mossmann/luna/hardware/rev0/luna_rev0.kicad_pcb

## KiCad design hardware/rev0/luna_rev0.kicad_pcb (2023-04-16)

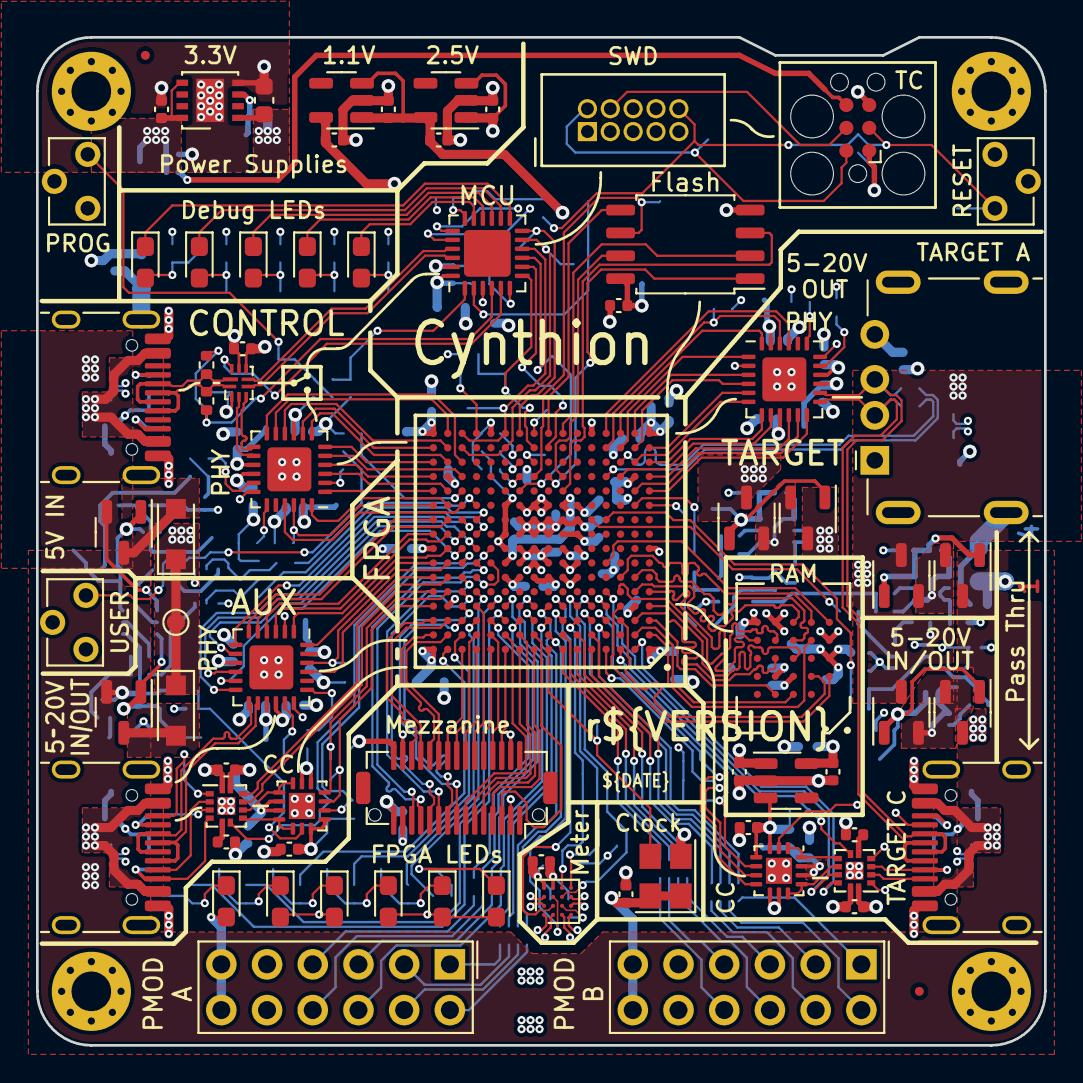
[picture p1: board luna_rev0.kicad_pcb from above]

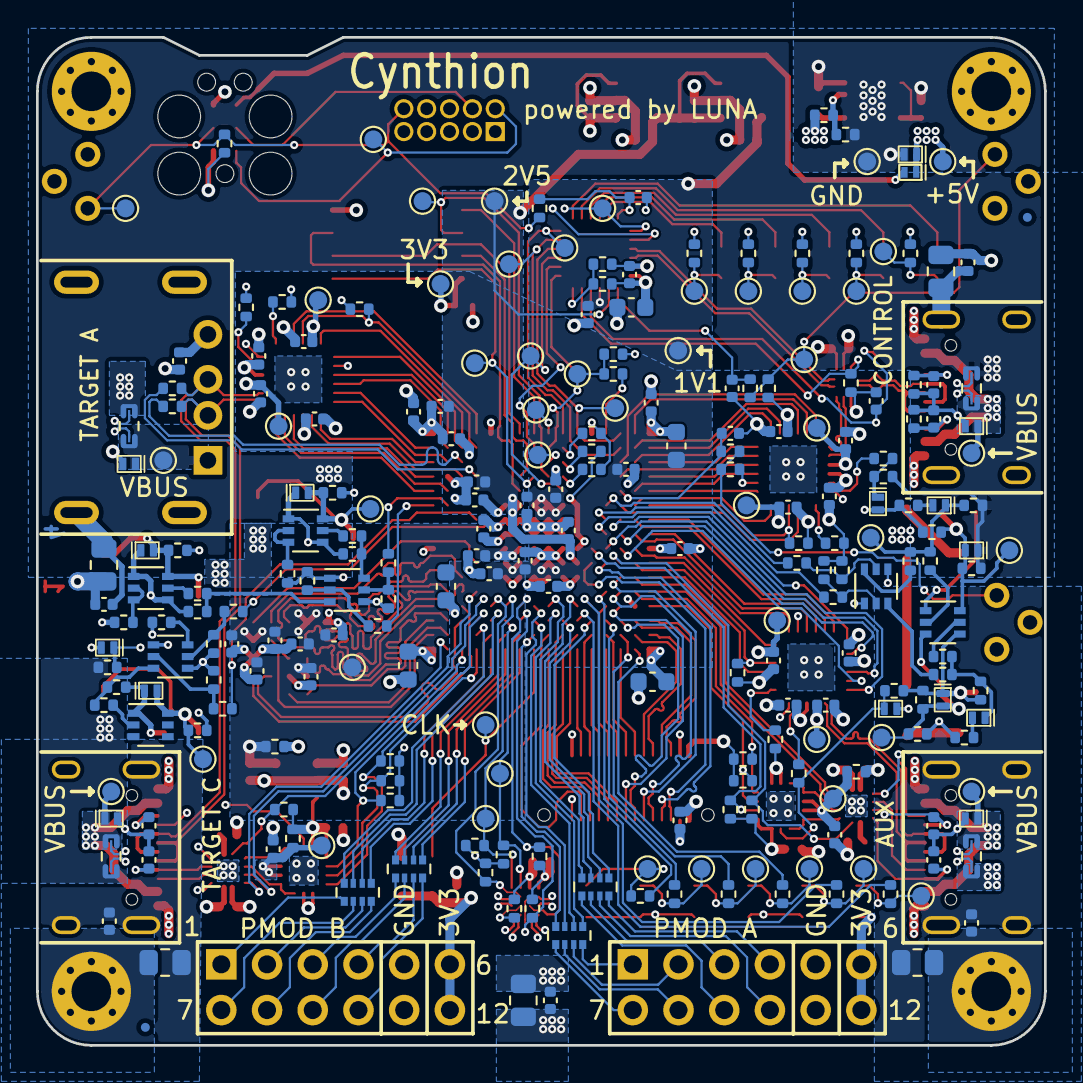
[picture p2: board luna_rev0.kicad_pcb from below]

Board: 4 copper layers, 56.0 x 56.0 mm, 322 parts (244 on the bottom side), 289 nets.

Parts:
C1, C2, C3, C4, C20, C73: 2.2uF; C_0603_1608Metric
C5, C6, C8, C13, C16, C17, C18, C19, C21, C22, C28, C29, C30, C34, C36, C37, C41, C42, C43, C48, C49, C50, C56, C58, C59, C60, C72, C74, C76, C77, C78: 1uF; C_0402_1005Metric
C7, C9, C10, C11, C12, C14, C15, C23, C24, C26, C27, C31, C32, C33, C35, C38, C39, C40, C44, C45, C46, C51, C57, C61, C63, C64, C65, C66, C67, C68, C69, C70, C71, C75: 0.1uF; C_0402_1005Metric
C25, C47, C52, C53, C54, C55: 330pF; C_0402_1005Metric
C62: 1nF; C_0402_1005Metric
D1, D8: SCHOTTKY; D_SOD-123F
D2: RED; LED_0603_1608Metric_Pad1.05x0.95mm_HandSolder
D3: ORANGE; LED_0603_1608Metric_Pad1.05x0.95mm_HandSolder
D4: YELLOW; LED_0603_1608Metric_Pad1.05x0.95mm_HandSolder
D5: GREEN; LED_0603_1608Metric_Pad1.05x0.95mm_HandSolder
D6: BLUE; LED_0603_1608Metric_Pad1.05x0.95mm_HandSolder
D7: PURPLE; LED_0603_1608Metric_Pad1.05x0.95mm_HandSolder
D9: SCHOTTKY; DSN1006-2
D10, D14: ICE BLUE; LED_0603_1608Metric_Pad1.05x0.95mm_HandSolder
D11, D13: PINK; LED_0603_1608Metric_Pad1.05x0.95mm_HandSolder
D12: WHITE; LED_0603_1608Metric_Pad1.05x0.95mm_HandSolder
D15, D18, D22: 24±2%; DFN1006-2
D16, D19, D20, D27, D28, D29: 6.2±2%; DFN1006-2
D17, D21: 5.6±2%; DFN1006-2
D23, D24, D25, D26: TVS; DFN1006-2
FID1, FID2, FID3, FID4: Fiducial; Fiducial_0.5mm_Mask1mm
H1, H2, H3, H4: MountingHole; MountingHole_2.2mm_M2_Pad_Via
IC1: ECP5-BGA256; lattice_cabga256
J1, J2, J4: USB_C; USB_C_Receptacle_HRO_TYPE-C-31-M-12
J3: USB_A; USB_A_Kycon_KUSBXHT-SB-AS1N-B30-NF_Horizontal
J5: MEZZANINE; Amphenol_10132798-03
J6: MCU_SWD; SWD_CONNECTOR_LARGE_BOX
J7: PMOD_A; PinSocket_2x06_P2.54mm_PMOD
J8: PMOD_B; PinSocket_2x06_P2.54mm_PMOD
J10: TC_SWD; Tag-Connect_TC2030-IDC-FP_2x03_P1.27mm_Vertical
Q1, Q2, Q4, Q5, Q6, Q7, Q9, Q12: PMOS; SOT-23-3
Q3, Q8, Q11: 2NPN; SOT-363_SC-70-6
Q10, Q13, Q14, Q15: 2PNP; SOT-363_SC-70-6
R1, R2, R42, R59: 0.02±1%; R_0603_1608Metric_Current_Sense
R3, R47, R48, R49, R60, R61, R69, R70, R76, R77, R104, R105, R107: 33k; R_0402_1005Metric
R4, R43, R50, R51, R103: 0; R_0805_2012Metric
R5, R8, R9, R10, R30, R31, R33, R38, R40, R63, R65, R71, R78, R83, R84, R88, R97, R98: 2.2k; R_0402_1005Metric
R6, R12, R13, R14, R15, R22, R23, R24, R25, R29, R37, R39, R41, R52, R53, R64, R66, R72, R79, R85, R86, R87, R89, R99, R100, R101, R106: 10k; R_0402_1005Metric
R7, R11, R34, R35, R44, R45, R46: 5.1k; R_0402_1005Metric
R16, R18, R20: 8.06k±1%; R_0402_1005Metric
R17, R19, R21: 20k; R_0402_1005Metric
R26, R27, R28, R57, R58: 1k; R_0402_1005Metric
R32, R36, R54, R102: 0; R_0402_1005Metric
R55, R56, R68, R75: 820k; R_0402_1005Metric
R62, R90, R91, R92, R93, R94, R95, R96: 100k; R_0402_1005Metric
R67, R73, R74, R80, R82: 18.7k±1%; R_0402_1005Metric
R81: 57.6k±1%; R_0402_1005Metric
RN1, RN2, RN3, RN4: 33; R_Array_Convex_4x0402
SW1: BTN_PROGRAM; SW_Tactile_SPST_Angled_TC-1109DE-B-F
SW2: BTN_RESET; SW_Tactile_SPST_Angled_TC-1109DE-B-F
SW3: BTN_USER; SW_Tactile_SPST_Angled_TC-1109DE-B-F
TP1, TP2, TP3, TP4, TP5, TP6, TP7, TP8, TP9, TP10, TP11, TP12, TP13, TP14, TP15, TP16, TP17, TP18, TP19, TP20, TP21, TP22, TP23, TP24, TP26, TP27, TP28, TP29, TP30, TP31, TP32, TP34, TP35, TP36, TP37, TP38, TP39, TP40, TP41, TP42, TP43, TP44, TP46, TP47, TP49, TP50, TP51, TP52, TP53, TP54, TP55: TestPoint; TestPoint_Pad_D1.0mm
U1: PAC1954; WLCSP-16_2.225x2.170mm_Layout4x4_P0.5mm
U2, U12: FUSB302B; WQFN-14-1EP_2.5x2.5mm_P0.5mm_EP1.45x1.45mm
U3: 3V3REG; DFN-8-1EP_3x3mm_P0.65mm_EP1.55x2.4mm
U4: 1V15REG; SOT-23-5
U5: 2V5REG; SOT-23-5
U6: ATSAMD11; QFN-24-1EP_4x4mm_P0.5mm_EP2.6x2.6mm
U7: W25Q32JVSS; SOIC-8_5.23x5.23mm_P1.27mm
U8, U9, U11: USB3343-CP; VQFN-24-1EP_4x4mm_P0.5mm_EP2.45x2.45mm
U10: HyperRAM; BGA-24_5x5_6.0x8.0mm
U13, U14: DPO2036; Diodes_UQFN2020-12_Type-B
U15: 1V8REG; SOT-23-5
U16: PI3USB102G; Diodes_10-TQFN_ZL
Y1: Osc60MHz; Crystal_SMD_3225-4Pin_3.2x2.5mm

Connections:
+1V1: C1.1, C3.1, C7.1, C9.1, C11.1, C13.1, C15.1, C17.1, C29.1, IC1.G6 (VCC_1), IC1.G7 (VCC_2), IC1.G9 (VCC_3), IC1.L8 (VCC_4), IC1.L9 (VCC_5), IC1.L10 (VCC_6), TP4.1, U4.5 (VOUT), U6.3 (PA04)
+2V5: C22.1, C24.1, C26.1, C27.1, C30.1, IC1.G11 (VCCAUX_1), IC1.L7 (VCCAUX_2), TP5.1, U4.1 (VIN), U4.3 (EN), U5.5 (VOUT), U6.2 (PA03)
+3V3: C2.1, C4.1, C8.1, C10.1, C12.1, C14.1, C16.1, C18.1, C20.1, C23.1, C28.1, C33.1, C34.1, C35.1, C38.1, C39.1, C40.1, C41.1, C44.1, C46.1, C49.1, C56.1, C58.1, C59.1, C61.1, C66.1, C67.1, C72.1, C73.1, C74.1, D2.2 (A), D3.2 (A), D4.2 (A), D5.2 (A), D6.2 (A), D7.2 (A), IC1.F6 (VCCIO0_1), IC1.F7 (VCCIO0_2), IC1.F10 (VCCIO1_1), IC1.F11 (VCCIO1_2), IC1.H11 (VCCIO2_1), IC1.J6 (VCCIO6_1), IC1.J7 (VCCIO6_2), IC1.J11 (VCCIO2_2), IC1.K11 (VCCIO3_1), IC1.L6 (VCCIO8), IC1.L11 (VCCIO3_2), J5.15, J5.16, J6.1 (VTref), J7.6, J7.12, J8.6, J8.12, J10.1, R6.1, R7.1, R8.1, R9.1, R10.1, R11.1, R13.2, R25.1, R32.2, R33.1, R36.2, R37.1, R38.1, R39.1, R52.1, R54.1, R81.1, R83.1, R84.1, R85.1, R86.1, R87.1, R97.1, R98.1, R99.1, R100.1, R101.1, R106.1, TP3.1, U1.A4 (VDD), U2.3 (VDD), U2.4 (VDD), U3.1 (OUT), U5.1 (VIN), U5.3 (EN), U6.24 (VDD), U7.8 (VCC), U8.2 (CLKOUT), U8.9 (VDDIO), U8.16 (VBAT), U8.18 (ID), U9.2 (CLKOUT), U9.9 (VDDIO), U9.16 (VBAT), U9.18 (ID), U11.2 (CLKOUT), U11.9 (VDDIO), U11.16 (VBAT), U11.18 (ID), U12.3 (VDD), U12.4 (VDD), U13.12 (VSYS), U14.12 (VSYS), U15.1 (VIN), U15.3 (EN), U16.9 (VCC), Y1.1 (EN), Y1.4 (VDD)
+5V: C6.1, D1.1 (K), D8.1 (K), D9.1 (K), D19.1 (K), TP30.1, TP49.1, U3.5 (EN), U3.8 (IN)
/AUX Port/AUX.CLK: IC1.F16 (PR14A), U11.21 (REFCLK/XI)
/AUX Port/AUX.DATA0: IC1.J16 (PR23A), U11.4 (DATA0)
/AUX Port/AUX.DATA1: IC1.K15 (PR23D), U11.5 (DATA1)
/AUX Port/AUX.DATA2: IC1.K16 (PR23C), U11.6 (DATA2)
/AUX Port/AUX.DATA3: IC1.J13 (PR17C), U11.7 (DATA3)
/AUX Port/AUX.DATA4: IC1.J14 (PR20C), U11.8 (DATA4)
/AUX Port/AUX.DATA5: IC1.H13 (PR17B), U11.10 (DATA5)
/AUX Port/AUX.DATA6: IC1.H14 (PR14D), U11.11 (DATA6)
/AUX Port/AUX.DATA7: IC1.K14 (PR20D), U11.12 (DATA7)
/AUX Port/AUX.DIR: IC1.H15 (PR20B), U11.1 (DIR)
/AUX Port/AUX.NXT: IC1.J15 (PR23B), U11.3 (NXT)
/AUX Port/AUX.STP: IC1.G16 (PR20A), U11.24 (STP)
/AUX Port/AUX.~RESET: IC1.G15 (PR14B), R24.1, U11.22 (RESET)
/AUX Port/AUX_CC1: C52.1, J1.A5 (CC1), U14.3 (CC1C)
/AUX Port/AUX_CC1S: U12.10 (CC1), U12.11 (CC1), U14.8 (CC1S)
/AUX Port/AUX_CC2: C53.1, J1.B5 (CC2), U14.4 (CC2C)
/AUX Port/AUX_CC2S: U12.1 (CC2), U12.14 (CC2), U14.7 (CC2S)
/AUX Port/AUX_D+: J1.A6 (D+), J1.B6 (D+), U11.14 (D+)
/AUX Port/AUX_D-: J1.A7 (D-), J1.B7 (D-), U11.13 (D-)
/AUX Port/AUX_PHY_1V8: C50.1, TP35.1, U11.23 (VDD18)
/AUX Port/AUX_SBU1: J1.A8 (SBU1), U14.2 (SBU2C)
/AUX Port/AUX_SBU1S: IC1.E16 (PR11D), U14.9 (SBU2S)
/AUX Port/AUX_SBU2: J1.B8 (SBU2), U14.1 (SBU1C)
/AUX Port/AUX_SBU2S: IC1.F15 (PR11C), U14.10 (SBU1S)
/AUX Port/AUX_SCL: IC1.D16 (PR8A), R38.2, U12.6 (SCL)
/AUX Port/AUX_SDA: IC1.E15 (PR8B), R33.2, U12.7 (SDA)
/AUX Port/AUX_VCONN: C51.1, R32.1, TP37.1, U12.12 (VCONN), U12.13 (VCONN)
/AUX Port/~AUX_FAULT: IC1.G14 (PR14C), R99.2, U14.6 (FAULTB)
/AUX Port/~AUX_INT: IC1.H12 (PR17A), R39.2, U12.5 (INT_N)
/CONTROL Port/CONTROL.CLK: IC1.L14 (PR32C), U8.21 (REFCLK/XI)
/CONTROL Port/CONTROL.DATA0: IC1.N16 (PR32A), U8.4 (DATA0)
/CONTROL Port/CONTROL.DATA1: IC1.N14 (PR35D), U8.5 (DATA1)
/CONTROL Port/CONTROL.DATA2: IC1.P16 (PR35A), U8.6 (DATA2)
/CONTROL Port/CONTROL.DATA3: IC1.P15 (PR32B), U8.7 (DATA3)
/CONTROL Port/CONTROL.DATA4: IC1.R16 (PR35B), U8.8 (DATA4)
/CONTROL Port/CONTROL.DATA5: IC1.R15 (PR38C), U8.10 (DATA5)
/CONTROL Port/CONTROL.DATA6: IC1.T15 (PR38D), U8.11 (DATA6)
/CONTROL Port/CONTROL.DATA7: IC1.P14 (PR38B), U8.12 (DATA7)
/CONTROL Port/CONTROL.DIR: IC1.M16 (PR26C), U8.1 (DIR)
/CONTROL Port/CONTROL.NXT: IC1.M15 (PR26D), U8.3 (NXT)
/CONTROL Port/CONTROL.STP: IC1.L15 (PR26B), U8.24 (STP)
/CONTROL Port/CONTROL.~RESET: IC1.L16 (PR26A), R22.1, U8.22 (RESET)
/CONTROL Port/CONTROL_CC1: C25.1, J2.A5 (CC1), R34.2
/CONTROL Port/CONTROL_CC2: C47.1, J2.B5 (CC2), R35.2
/CONTROL Port/CONTROL_D+: J2.A6 (D+), J2.B6 (D+), R56.2, U16.2 (D-)
/CONTROL Port/CONTROL_D-: J2.A7 (D-), J2.B7 (D-), R55.1, U16.1 (D+)
/CONTROL Port/CONTROL_FPGA_D+: U8.14 (D+), U16.4 (1D-)
/CONTROL Port/CONTROL_FPGA_D-: U8.13 (D-), U16.5 (1D+)
/CONTROL Port/CONTROL_MCU_D+: U6.22 (PA25), U16.6 (2D-)
/CONTROL Port/CONTROL_MCU_D-: U6.21 (PA24), U16.7 (2D+)
/CONTROL Port/CONTROL_PHY_1V8: C37.1, TP17.1, U8.23 (VDD18)
/CONTROL Port/CONTROL_RESET_DETECT: C62.1, R55.2, R56.1, U6.4 (PA05)
/CONTROL Port/CONTROL_SWITCH: R15.1, U6.5 (PA06), U16.10 (S)
/CONTROL Port/CONTROL_VBUS_CLAMPED: D22.1 (K), R17.1, R46.1
/CONTROL Port/~AUX_VBUS_IN_EN: IC1.L13 (PR29C), R78.2
/CONTROL Port/~BTN_USER: R106.2, R107.2, SW3.1
/CONTROL Port/~CONTROL_VBUS_IN_EN: IC1.K13 (PR29A), R71.2
/CONTROL Port/~FPGA_SELF_PROGRAM: IC1.T13 (PR44B), R5.2
/Clock and Pmod/CLKIN_60MHZ: IC1.A8 (PT29B), TP1.1, Y1.3 (OUT)
/Clock and Pmod/TARGET_C.SBU1S: IC1.A2 (PT4A), U13.10 (SBU1S)
/Clock and Pmod/TARGET_C.SBU2S: IC1.E4 (PT9A), U13.9 (SBU2S)
/Clock and Pmod/TARGET_C.SCL: IC1.A4 (PT6B), R98.2, U2.6 (SCL)
/Clock and Pmod/TARGET_C.SDA: IC1.C4 (PT11A), R97.2, U2.7 (SDA)
/Clock and Pmod/TARGET_C.~FAULT: IC1.D4 (PT9B), R100.2, U13.6 (FAULTB)
/Clock and Pmod/TARGET_C.~INT: IC1.A3 (PT6A), R37.2, U2.5 (INT_N)
/Debugger and FPGA Configuration/D0: IC1.T8 (D0/PICO/PB11B), U7.5 (DI(IO0))
/Debugger and FPGA Configuration/D1: IC1.T7 (D1/POCI/PB11A), U7.2 (DO(IO1))
/Debugger and FPGA Configuration/D2: IC1.M7 (D2/PB9B), U7.3 (IO2)
/Debugger and FPGA Configuration/D3: IC1.N7 (D3/PB9A), U7.7 (IO3)
/Debugger and FPGA Configuration/FPGA_CFG0: IC1.N10 (CFG_0), R12.1
/Debugger and FPGA Configuration/FPGA_CFG1: IC1.P10 (CFG_1), R13.1
/Debugger and FPGA Configuration/FPGA_CFG2: IC1.R10 (CFG_2), R14.1
/Debugger and FPGA Configuration/FPGA_CONFIG_CLK: IC1.N9 (MCLK/SCLK/CCLK), TP10.1, U7.6 (CLK)
/Debugger and FPGA Configuration/FPGA_DONE: IC1.P9 (DONE), TP12.1
/Debugger and FPGA Configuration/FPGA_INT: IC1.R8 (SN/CSN/PB13A), U6.8 (PA09/XOUT)
/Debugger and FPGA Configuration/FPGA_TCK: IC1.T10 (TCK), TP21.1, U6.12 (PA15)
/Debugger and FPGA Configuration/FPGA_TDI: IC1.R11 (TDI), IC1.R14 (PR41B), TP24.1, U6.11 (PA14)
/Debugger and FPGA Configuration/FPGA_TDO: IC1.M10 (TDO), TP23.1, U6.9 (PA10)
/Debugger and FPGA Configuration/FPGA_TMS: IC1.T11 (TMS), IC1.T14 (PR41D), TP22.1, U6.10 (PA11)
/Debugger and FPGA Configuration/MCU_SWDCLK: J6.4 (SWDCLK/TCK), J10.4, TP19.1, U6.19 (PA30/SWCLK)
/Debugger and FPGA Configuration/MCU_SWDIO: J6.2 (SWDIO/TMS), J10.2, TP20.1, U6.20 (PA31/SWDIO)
/Debugger and FPGA Configuration/~BTN_PROGRAM: R101.2, R104.2, SW1.1, TP15.1
/Debugger and FPGA Configuration/~BTN_RESET: J6.10 (~RESET), J10.3, R25.2, R105.1, SW2.1, TP18.1
/Debugger and FPGA Configuration/~CS_DI: IC1.N8 (HOLDN/DI/PB15A), TP11.1, U7.1 (~CS)
/Debugger and FPGA Configuration/~FPGA_INIT: IC1.T9 (INITN), TP13.1
/Debugger and FPGA Configuration/~FPGA_PROGRAM: IC1.R9 (PROGRAMN), R5.1, R6.2, TP14.1, U6.7 (PA08/XIN)
/LEDs and Pmod/LED0: IC1.E13 (PT62B), R31.2
/LEDs and Pmod/LED1: IC1.C13 (PT60B), R30.2
/LEDs and Pmod/LED2: IC1.B14 (PT67A), R29.2
/LEDs and Pmod/LED3: IC1.A15 (PT67B), R28.2
/LEDs and Pmod/LED4: IC1.D12 (PT58A), R27.2
/LEDs and Pmod/LED5: IC1.C11 (PT49B), R26.2
/PMOD_A0: J7.1, RN1.8 (R1.2)
/PMOD_A1: J7.2, RN1.7 (R2.2)
/PMOD_A2: J7.3, RN2.6 (R3.2)
/PMOD_A3: J7.4, RN2.8 (R1.2)
/PMOD_A4: J7.7, RN1.5 (R4.2)
/PMOD_A5: J7.8, RN1.6 (R3.2)
/PMOD_A6: J7.9, RN2.5 (R4.2)
/PMOD_A7: J7.10, RN2.7 (R2.2)
/PMOD_B0: J8.1, RN4.5 (R4.2)
/PMOD_B1: J8.2, RN4.7 (R2.2)
/PMOD_B2: J8.3, RN3.5 (R4.2)
/PMOD_B3: J8.4, RN3.7 (R2.2)
/PMOD_B4: J8.7, RN4.6 (R3.2)
/PMOD_B5: J8.8, RN4.8 (R1.2)
/PMOD_B6: J8.9, RN3.6 (R3.2)
/PMOD_B7: J8.10, RN3.8 (R1.2)
/Power Distribution and Monitoring/ADDRSEL: R102.2, U1.C2 (ADDRSEL)
/Power Distribution and Monitoring/AUX_VBUS: D25.1 (K), J1.A4 (VBUS), J1.A9 (VBUS), J1.B4 (VBUS), J1.B9 (VBUS), R42.4, TP34.1
/Power Distribution and Monitoring/AUX_VBUS_EN: IC1.L2 (PL26B), R63.2
/Power Distribution and Monitoring/CONTROL_VBUS: D23.1 (K), J2.A4 (VBUS), J2.A9 (VBUS), J2.B4 (VBUS), J2.B9 (VBUS), R1.1, TP16.1
/Power Distribution and Monitoring/CONTROL_VBUS_EN: IC1.L1 (PL26A), R40.2
/Power Distribution and Monitoring/TARGET_A_DISCHARGE: IC1.K4 (PL29A), R88.2
/Power Distribution and Monitoring/TARGET_A_VBUS: D24.1 (K), J3.1 (VBUS), R2.4, TP7.1
/Power Distribution and Monitoring/TARGET_C_VBUS: D26.1 (K), J4.A4 (VBUS), J4.A9 (VBUS), J4.B4 (VBUS), J4.B9 (VBUS), R59.4, TP40.1
/Power Distribution and Monitoring/~TARGET_C_VBUS_EN: IC1.K5 (PL29B), R65.2
/RAM/RAM.CK: IC1.C3 (PL2C), U10.B2 (CK)
/RAM/RAM.DQ0: IC1.F2 (PL11C), U10.D3 (DQ0)
/RAM/RAM.DQ1: IC1.B1 (PL2A), U10.D2 (DQ1)
/RAM/RAM.DQ2: IC1.C2 (PL5B), U10.C4 (DQ2)
/RAM/RAM.DQ3: IC1.E1 (PL11D), U10.D4 (DQ3)
/RAM/RAM.DQ4: IC1.E3 (PL5C), U10.D5 (DQ4)
/RAM/RAM.DQ5: IC1.E2 (PL8B), U10.E3 (DQ5)
/RAM/RAM.DQ6: IC1.F3 (PL5D), U10.E2 (DQ6)
/RAM/RAM.DQ7: IC1.G4 (PL11B), U10.E1 (DQ7)
/RAM/RAM.RWDS: IC1.D1 (PL8A), U10.C3 (RWDS)
/RAM/RAM.~CK: IC1.D3 (PL2D), U10.B1 (~CK)
/RAM/RAM.~CS: IC1.B2 (PL2B), U10.A3 (~CS)
/RAM/RAM.~RESET: IC1.C1 (PL5A), U10.A4 (~RESET)
/TARGET Port/TARGET.CLK: IC1.T4 (PL44B), U9.21 (REFCLK/XI)
/TARGET Port/TARGET.DATA0: IC1.R2 (PL38C), U9.4 (DATA0)
/TARGET Port/TARGET.DATA1: IC1.R1 (PL35B), U9.5 (DATA1)
/TARGET Port/TARGET.DATA2: IC1.P2 (PL32B), U9.6 (DATA2)
/TARGET Port/TARGET.DATA3: IC1.P1 (PL35A), U9.7 (DATA3)
/TARGET Port/TARGET.DATA4: IC1.N3 (PL35D), U9.8 (DATA4)
/TARGET Port/TARGET.DATA5: IC1.N1 (PL32A), U9.10 (DATA5)
/TARGET Port/TARGET.DATA6: IC1.M2 (PL26D), U9.11 (DATA6)
/TARGET Port/TARGET.DATA7: IC1.M1 (PL26C), U9.12 (DATA7)
/TARGET Port/TARGET.DIR: IC1.R3 (PL41B), U9.1 (DIR)
/TARGET Port/TARGET.NXT: IC1.T2 (PL38D), U9.3 (NXT)
/TARGET Port/TARGET.STP: IC1.T3 (PL41D), U9.24 (STP)
/TARGET Port/TARGET.~RESET: IC1.R4 (PL41C), R23.1, U9.22 (RESET)
/TARGET Port/TARGET_CC1: C54.1, J4.A5 (CC1), U13.3 (CC1C)
/TARGET Port/TARGET_CC1S: U2.10 (CC1), U2.11 (CC1), U13.8 (CC1S)
/TARGET Port/TARGET_CC2: C55.1, J4.B5 (CC2), U13.4 (CC2C)
/TARGET Port/TARGET_CC2S: U2.1 (CC2), U2.14 (CC2), U13.7 (CC2S)
/TARGET Port/TARGET_D+: J3.3 (D+), J4.A6 (D+), J4.B6 (D+), R58.1, U9.14 (D+)
/TARGET Port/TARGET_D-: J3.2 (D-), J4.A7 (D-), J4.B7 (D-), R57.1, U9.13 (D-)
/TARGET Port/TARGET_FS_MONITOR_D+: IC1.N4 (PL38A), R58.2
/TARGET Port/TARGET_FS_MONITOR_D-: IC1.P3 (PL38B), R57.2
/TARGET Port/TARGET_PHY_1V8: C43.1, TP27.1, U9.23 (VDD18)
/TARGET Port/TARGET_SBU1: J4.A8 (SBU1), U13.1 (SBU1C)
/TARGET Port/TARGET_SBU2: J4.B8 (SBU2), U13.2 (SBU2C)
/TARGET Port/TARGET_VCONN: C45.1, R36.1, TP36.1, U2.12 (VCONN), U2.13 (VCONN)
AUX_SENSE+: R42.3, U1.A3 (SENSE1+)
AUX_SENSE-: R42.2, U1.A2 (SENSE1-)
AUX_VBUS_CLAMPED: D15.1 (K), R21.1, R44.1, U12.2 (VBUS)
AUX_VBUS_IN: D20.1 (K), Q4.3 (D), Q10.4 (E2), Q12.2 (S), R42.1, R44.2, R74.1, R75.1
CONTROL_SENSE+: R1.2, U1.A1 (SENSE2+)
CONTROL_SENSE-: R1.3, U1.B1 (SENSE2-)
CONTROL_VBUS_IN: D16.1 (K), Q1.3 (D), Q9.2 (S), Q10.1 (E1), R1.4, R46.2, R67.1, R68.1
GND: C1.2, C2.2, C3.2, C4.2, C5.2, C6.2, C7.2, C8.2, C9.2, C10.2, C11.2, C12.2, C13.2, C14.2, C15.2, C16.2, C17.2, C18.2, C19.2, C20.2, C21.2, C22.2, C23.2, C24.2, C25.2, C26.2, C27.2, C28.2, C29.2, C30.2, C31.2, C32.2, C33.2, C34.2, C35.2, C36.2, C37.2, C38.2, C39.2, C40.2, C41.2, C42.2, C43.2, C44.2, C45.2, C46.2, C47.2, C48.2, C49.2, C50.2, C51.2, C52.2, C53.2, C54.2, C55.2, C56.2, C57.2, C58.2, C59.2, C60.2, C61.2, C62.2, C63.2, C64.2, C65.2, C66.2, C67.2, C72.2, C73.2, C74.2, C75.2, C76.2, C77.2, C78.2, D15.2 (A), D18.2 (A), D19.2 (A), D22.2 (A), D23.2 (A), D24.2 (A), D25.2 (A), D26.2 (A), IC1.A1 (GND_1), IC1.A16 (GND_2), IC1.D2 (GND_3), IC1.D15 (GND_4), IC1.F8 (GND_5), IC1.F9 (GND_6), IC1.G8 (GND_7), IC1.G10 (GND_8), IC1.H1 (GND_9), IC1.H8 (GND_10), IC1.H9 (GND_11), IC1.H10 (GND_12), IC1.H16 (GND_13), IC1.J8 (GND_14), IC1.J9 (GND_15), IC1.J10 (GND_16), IC1.K6 (GND_17), IC1.K7 (GND_18), IC1.K8 (GND_19), IC1.K9 (GND_20), IC1.K10 (GND_21), IC1.N2 (GND_22), IC1.N15 (GND_23), IC1.T1 (GND_24), IC1.T5 (GND_25), IC1.T12 (GND_26), IC1.T16 (GND_27), J1.A1 (GND), J1.A12 (GND), J1.B1 (GND), J1.B12 (GND), J2.A1 (GND), J2.A12 (GND), J2.B1 (GND), J2.B12 (GND), J3.4 (GND), J4.A1 (GND), J4.A12 (GND), J4.B1 (GND), J4.B12 (GND), J5.2, J5.14, J5.17, J5.29, J6.3 (GND), J6.5 (GND), J6.9 (GNDDetect), J7.5, J7.11, J8.5, J8.11, J10.5, Q3.1 (E1), Q3.4 (E2), Q8.1 (E1), Q8.4 (E2), Q11.1 (E1), Q11.4 (E2), R12.2, R14.2, R15.2, R16.1, R18.1, R20.1, R22.2, R23.2, R24.2, R34.1, R35.1, R41.2, R53.2, R64.2, R66.2, R70.2, R72.2, R73.2, R77.2, R79.2, R80.2, R82.2, R89.2, R90.1, R91.1, R94.1, R95.1, R96.1, R102.1, R103.1, SW1.2, SW2.2, SW3.2, TP28.1, U1.B4 (GND), U2.8 (GND), U2.9 (GND), U2.15 (GND), U3.4 (GND), U3.9 (GND), U4.2 (GND), U5.2 (GND), U6.23 (GND), U7.4 (GND), U8.25 (GND), U9.25 (GND), U10.B3 (VSS), U10.C1 (VSSQ), U10.E5 (VSSQ), U11.25 (GND), U12.8 (GND), U12.9 (GND), U12.15 (GND), U13.11 (GND), U13.13 (GND), U14.11 (GND), U14.13 (GND), U15.2 (GND), U16.3 (GND), U16.8 (~OE), Y1.2 (GND)
MEZZANINE3: IC1.B9 (PT38A), J5.3
MEZZANINE4: IC1.A9 (PT42A), J5.4
MEZZANINE5: IC1.B10 (PT44A), J5.5
MEZZANINE6: IC1.A10 (PT42B), J5.6
MEZZANINE7: IC1.B11 (PT49A), J5.7
MEZZANINE22: IC1.A14 (PT65B), J5.22
MEZZANINE23: IC1.B13 (PT60A), J5.23
MEZZANINE24: IC1.A13 (PT65A), J5.24
MEZZANINE25: IC1.D13 (PT62A), J5.25
MEZZANINE26: IC1.A12 (PT53B), J5.26
MEZZANINE27: IC1.B12 (PT56A), J5.27
MEZZANINE28: IC1.A11 (PT53A), J5.28
MON.GPIO: IC1.D7 (PT24B), R86.2, U1.B2 (GPIO/~ALERT2)
MON.SCL: IC1.C6 (PT22A), R83.2, TP50.1, U1.C4 (SCL)
MON.SDA: IC1.D6 (PT20B), R84.2, TP51.1, U1.D4 (SDA)
MON.SLOW: IC1.D5 (PT13B), R85.2, U1.C3 (SLOW/~ALERT)
MON.~PWRDN: IC1.C7 (PT27A), R87.2, U1.B3 (~PWRDN)
unnamed: C36.1, TP26.1, U8.15 (VDD33)
unnamed: C42.1, TP9.1, U9.15 (VDD33)
unnamed: C48.1, TP2.1, U11.15 (VDD33)
unnamed: C57.1, U13.5 (CB)
unnamed: C63.1, U14.5 (CB)
unnamed: C68.1, J3.5 (Shield), R4.2
unnamed: C69.2, J1.S1 (SHIELD), R43.1
unnamed: C70.1, J4.S1 (SHIELD), R50.2
unnamed: C71.2, J2.S1 (SHIELD), R51.1
unnamed: D1.2 (A), Q12.3 (D)
unnamed: D2.1 (K), R26.1, TP43.1
unnamed: D3.1 (K), R27.1, TP47.1
unnamed: D4.1 (K), R28.1, TP52.1
unnamed: D5.1 (K), R29.1, TP53.1
unnamed: D6.1 (K), R30.1, TP54.1
unnamed: D7.1 (K), R31.1, TP55.1
unnamed: D8.2 (A), Q9.3 (D)
unnamed: D9.2 (A), J10.6
unnamed: D10.1 (K), U6.13 (PA16)
unnamed: D10.2 (A), R7.2, TP31.1
unnamed: D11.1 (K), U6.14 (PA17)
unnamed: D11.2 (A), R8.2, TP32.1
unnamed: D12.1 (K), U6.15 (PA22)
unnamed: D12.2 (A), R9.2, TP38.1
unnamed: D13.1 (K), U6.16 (PA23)
unnamed: D13.2 (A), R10.2, TP39.1
unnamed: D14.1 (K), U6.17 (PA27)
unnamed: D14.2 (A), R11.2, TP41.1
unnamed: D16.2 (A), Q9.1 (G), Q10.6 (C1), R68.2, R70.1, TP8.1
unnamed: D17.1 (K), R47.2, R67.2, R69.1, TP44.1
unnamed: D17.2 (A), R73.1
unnamed: D20.2 (A), Q10.3 (C2), Q12.1 (G), R75.2, R77.1, TP46.1
unnamed: D21.1 (K), R48.2, R74.2, R76.1
unnamed: D21.2 (A), R80.1
unnamed: D27.1 (K), Q1.2 (S), Q2.2 (S), Q13.1 (E1), Q13.4 (E2), R3.1
unnamed: D27.2 (A), Q1.1 (G), Q2.1 (G), Q13.6 (C1), R90.2, TP29.1
unnamed: D28.1 (K), Q4.2 (S), Q5.2 (S), Q14.1 (E1), Q14.4 (E2), R60.1
unnamed: D28.2 (A), Q4.1 (G), Q5.1 (G), Q14.6 (C1), R94.2
unnamed: D29.1 (K), Q6.2 (S), Q7.2 (S), Q15.1 (E1), R61.1
unnamed: D29.2 (A), Q6.1 (G), Q7.1 (G), Q15.6 (C1), R96.2, TP42.1
unnamed: IC1.A5 (PT18A), RN4.1 (R1.1)
unnamed: IC1.A6 (PT18B), RN3.3 (R3.1)
unnamed: IC1.A7 (PT29A), RN3.1 (R1.1)
unnamed: IC1.B4 (PT11B), RN4.4 (R4.1)
unnamed: IC1.B5 (PT15B), RN4.2 (R2.1)
unnamed: IC1.B6 (PT22B), RN3.4 (R4.1)
unnamed: IC1.B7 (PT27B), RN3.2 (R2.1)
unnamed: IC1.B8 (PT35B), RN1.4 (R4.1)
unnamed: IC1.B15 (PR2B), J5.21
unnamed: IC1.B16 (PR2A), J5.20
unnamed: IC1.C5 (PT15A), RN4.3 (R3.1)
unnamed: IC1.C8 (PT35A), RN1.2 (R2.1)
unnamed: IC1.C9 (PT38B), RN1.1 (R1.1)
unnamed: IC1.C10 (PT44B), RN2.2 (R2.1)
unnamed: IC1.C12 (PT56B), RN2.1 (R1.1)
unnamed: IC1.C14 (PR2C), J5.9
unnamed: IC1.C15 (PR5B), J5.19
unnamed: IC1.C16 (PR5A), J5.18
unnamed: IC1.D8 (PT33B), RN1.3 (R3.1)
unnamed: IC1.D9 (PT40A), RN2.4 (R4.1)
unnamed: IC1.D11 (PT51A), RN2.3 (R3.1)
unnamed: IC1.D14 (PR2D), J5.8
unnamed: IC1.E14 (PR5C), J5.11
unnamed: IC1.F14 (PR5D), J5.10
unnamed: IC1.G12 (PR11A), J5.13
unnamed: IC1.G13 (PR11B), J5.12
unnamed: C78.1, IC1.M14 (PR32D), R107.1
unnamed: Q3.2 (B1), R40.1, R41.1
unnamed: Q3.3 (C2), R60.2, R92.1
unnamed: Q3.5 (B2), R63.1, R64.1
unnamed: Q3.6 (C1), R3.2, R62.1
unnamed: Q8.2 (B1), R65.1, R66.1
unnamed: Q8.3 (C2), R49.2
unnamed: Q8.5 (B2), R88.1, R89.1
unnamed: Q8.6 (C1), R61.2, R93.1
unnamed: Q10.2 (B1), R47.1
unnamed: Q10.5 (B2), R48.1
unnamed: Q11.2 (B1), R71.1, R72.1
unnamed: Q11.3 (C2), R76.2
unnamed: Q11.5 (B2), R78.1, R79.1
unnamed: Q11.6 (C1), R69.2
unnamed: Q13.2 (B1), Q13.3 (C2), R91.2
unnamed: Q13.5 (B2), R62.2
unnamed: Q14.2 (B1), Q14.3 (C2), R95.2
unnamed: Q14.5 (B2), R92.2
unnamed: Q15.2 (B1), R93.2
unnamed: R16.2, U8.19 (RBIAS)
unnamed: R17.2, U8.17 (VBUS)
unnamed: R18.2, U9.19 (RBIAS)
unnamed: R19.2, U9.17 (VBUS)
unnamed: R20.2, U11.19 (RBIAS)
unnamed: R21.2, U11.17 (VBUS)
unnamed: R52.2, R53.1, U6.6 (PA07)
unnamed: R81.2, R82.1, U3.3 (ADJ/NC)
unnamed: C76.1, R104.1, U6.1 (PA02)
unnamed: C77.1, R105.2, U6.18 (PA28/~RST)
SHIELD: C68.2, C69.1, C70.2, C71.1, C75.1, H1.1, H2.1, H3.1, H4.1, R4.1, R43.2, R50.1, R51.2, R103.2, SW1.3 (SHIELD), SW2.3 (SHIELD), SW3.3 (SHIELD)
TARGET_A_SENSE+: R2.3, U1.D1 (SENSE3+)
TARGET_A_SENSE-: R2.2, U1.C1 (SENSE3-)
TARGET_A_VBUS_IN: Q2.3 (D), Q5.3 (D), Q6.3 (D), R2.1, R49.1
TARGET_C_SENSE+: R59.3, U1.D3 (SENSE4+)
TARGET_C_SENSE-: R59.2, U1.D2 (SENSE4-)
TARGET_C_VBUS_CLAMPED: D18.1 (K), R19.1, R45.1, U2.2 (VBUS)
TARGET_C_VBUS_IN: Q7.3 (D), R45.2, R59.1
VCCRAM: C5.1, C19.1, C21.1, C31.1, C32.1, C60.1, C64.1, C65.1, IC1.H6 (VCCIO7_1), IC1.H7 (VCCIO7_2), R54.2, TP6.1, U10.B4 (VCC), U10.D1 (VCCQ), U10.E4 (VCCQ), U15.5 (VOUT)
