mossmann/luna/(commit log)

2023-01-19 hardware: update revision to r0.5+
    [clock_pmod.kicad_sch, fpga_configuration.kicad_sch, host_side.kicad_sch, luna_rev0.kicad_pcb, luna_rev0.kicad_sch, power_supplies.kicad_sch, ram_section.kicad_sch, right_side_indicators.kicad_sch]
2023-01-19 hardware: add FPGA bank outlines to Comments layer
    [luna_rev0.kicad_pcb]
2023-02-06 hardware: remove debug SPI interface
    [luna_rev0.kicad_pcb, luna_rev0.kicad_sch, right_side_indicators.kicad_sch]
2023-02-06 hardware: update SPI signal names
    based on latest OSHWA guidance
    [clock_pmod.kicad_sch, fpga_configuration.kicad_sch, host_side.kicad_sch, luna_rev0.kicad_pcb, power_supplies.kicad_sch, ram_section.kicad_sch, right_side_indicators.kicad_sch, sideband_side.kicad_sch]
2023-02-06 hardware: remove TARGET_VBUS_C measurement
    [fpga_configuration.kicad_sch, luna_rev0.kicad_pcb, luna_rev0.kicad_sch]
2023-02-06 hardware: remove PHY 1.8 V measurement
    [fpga_configuration.kicad_sch, host_side.kicad_sch, luna_rev0.kicad_pcb, luna_rev0.kicad_sch, sideband_side.kicad_sch, target_side.kicad_sch]
2023-02-06 hardware: remove user i/o SMA connectors
    [host_side.kicad_sch, luna_rev0.kicad_pcb, luna_rev0.kicad_sch]
2023-02-06 hardware: rename buses for KiCad 6
    [fpga_configuration.kicad_sch, host_side.kicad_sch, luna_rev0.kicad_pcb, luna_rev0.kicad_sch, ram_section.kicad_sch, right_side_indicators.kicad_sch, sideband_side.kicad_sch, target_side.kicad_sch]
2023-02-06 hardware: correct or exclude all ERC errors
    [fpga_configuration.kicad_sch, luna_rev0.kicad_pcb, luna_rev0.kicad_sch, right_side_indicators.kicad_sch]
2023-02-06 hardware: use DNP field for DNP notation
    [clock_pmod.kicad_sch, fpga_configuration.kicad_sch, host_side.kicad_sch, luna_rev0.kicad_pcb, power_supplies.kicad_sch, right_side_indicators.kicad_sch, sideband_side.kicad_sch, target_side.kicad_sch]
2023-02-06 hardware: consistently use lowercase k for kilo
    [fpga_configuration.kicad_sch, host_side.kicad_sch, luna_rev0.kicad_pcb, luna_rev0.kicad_sch, power_supplies.kicad_sch, right_side_indicators.kicad_sch, sideband_side.kicad_sch, target_side.kicad_sch]
2023-02-07 hardware: correct or exclude all DRC errors
    [clock_pmod.kicad_sch, fpga_configuration.kicad_sch, host_side.kicad_sch, luna_rev0.kicad_pcb, luna_rev0.kicad_sch, power_supplies.kicad_sch, ram_section.kicad_sch, right_side_indicators.kicad_sch]
2023-02-07 hardware: shift absolute board position
    [luna_rev0.kicad_pcb]
2023-02-07 hardware: update mechanical design
    See Users.Drawings layer for dimensions and constraints. This breaks
    functionality of the layout. Function will be restored after upcoming
    changes to the schematic.
    [clock_pmod.kicad_sch, fpga_configuration.kicad_sch, host_side.kicad_sch, luna_rev0.kicad_pcb, luna_rev0.kicad_sch, power_supplies.kicad_sch, ram_section.kicad_sch, right_side_indicators.kicad_sch]
2023-02-14 hardware: add button BTN to FPGA
    intended for SoC reset or alternative FPGA use
    [fpga_configuration.kicad_sch, luna_rev0.kicad_sch]
2023-02-14 hardware: move DFU button to its own pin
    no longer shared with LED
    [fpga_configuration.kicad_sch]
2023-02-15 hardware: add 0 ohm resistors to USB shields
    provides ability to disconnect each shield from GND
    [luna_rev0.kicad_sch]
2023-02-15 hardware: add mounting holes connected to GND
    [luna_rev0.kicad_sch]
2023-02-15 hardware: add Pmod connector population note
    populate only when assembling for installation in enclosure
    [luna_rev0.kicad_sch]
2023-02-15 hardware: move 2V5 measurement from PA07 to PA03
    [fpga_configuration.kicad_sch]
2023-02-15 hardware: add pin strap for version detection
    [fpga_configuration.kicad_sch, luna_rev0.kicad_sch]
2023-02-16 hardware: add FPGA interrupt
    allows FPGA to signal that it has something to say to the
    microcontroller
    [fpga_configuration.kicad_sch]
2023-02-16 hardware: migrate symbol libraries to KiCad 6
2023-02-16 hardware: restore 1.8 V RAM supply as an option
    [fpga_configuration.kicad_sch, luna_rev0.kicad_sch, power_supplies.kicad_sch, ram_section.kicad_sch]
2023-02-16 hardware: reassign FPGA I/O banks
    assign HyperRAM to DQS group
    [clock_pmod.kicad_sch, host_side.kicad_sch, luna_rev0.kicad_pcb, luna_rev0.kicad_sch, ram_section.kicad_sch, right_side_indicators.kicad_sch, sideband_side.kicad_sch, target_side.kicad_sch]
2023-02-16 hardware: rename USB ports
    Sideband is renamed to Control and is intended for use as the primary
    control port for both the FPGA and the microcontroller/debugger.
    Host is renamed to Aux and is intended for auxiliary functions
    including MitM.
    [clock_pmod.kicad_sch, fpga_configuration.kicad_sch, host_side.kicad_sch, luna_rev0.kicad_pcb, luna_rev0.kicad_sch, sideband_side.kicad_sch, target_side.kicad_sch]
2023-02-16 hardware: rename schematic files
    [aux_port.kicad_sch, control_port.kicad_sch, indicators_pmod.kicad_sch, luna_rev0.kicad_pcb, luna_rev0.kicad_sch, target_port.kicad_sch]
2023-02-16 hardware: add Control port USB switch
    [control_port.kicad_sch, fpga_configuration.kicad_sch, luna_rev0.kicad_pcb, luna_rev0.kicad_sch]
2023-02-17 hardware: add Control port reset detection
    USB reset can be detected by measuring the D+/D- common-mode voltage
    with the microcontroller's ADC or analog comparator.
    [control_port.kicad_sch, fpga_configuration.kicad_sch, luna_rev0.kicad_sch]
2023-02-17 hardware: add Target D+/D- full-speed monitor
    allows FPGA to monitor low-speed or full-speed USB directly (instead of
    or in addition to the high-speed PHY)
    [luna_rev0.kicad_sch, target_port.kicad_sch]
2023-02-17 hardware: replace VBUS pass-through switches
    - increase maximum voltage with discrete FET solution
    - pass through Control and Aux VBUS directly, not +5V supply rail
    - add current sense resistors
    - eliminate discharge current of previous power switches
    - eliminate possible overvoltage condition of previous power switches
    - remove 10 uF VBUS output capacitor C53
    [aux_port.kicad_sch, clock_pmod.kicad_sch, control_port.kicad_sch, fpga_configuration.kicad_sch, indicators_pmod.kicad_sch, luna_rev0.kicad_pcb, luna_rev0.kicad_sch, power_distribution.kicad_sch]
2023-02-17 hardware: replace power input diodes
    - provide input selection capability with FETs
    - reduce reverse leakage current
    - provide overvoltage protection
    [aux_port.kicad_sch, luna_rev0.kicad_pcb, luna_rev0.kicad_sch, power_distribution.kicad_sch]
2023-02-17 hardware: replace +3V3 regulator U3
    - support higher current
    - improve heat dissipation
    [luna_rev0.kicad_pcb, luna_rev0.kicad_sch, power_distribution.kicad_sch, power_supplies.kicad_sch]
2023-02-17 hardware: add VBUS voltage and current monitoring
    [luna_rev0.kicad_pcb, luna_rev0.kicad_sch, power_distribution.kicad_sch, target_port.kicad_sch]
2023-02-17 hardware: add Target port Type-C controller
    replaces buffers for CC pin I/O
    [indicators_pmod.kicad_sch, luna_rev0.kicad_pcb, luna_rev0.kicad_sch, target_port.kicad_sch]
2023-02-17 hardware: add Aux port Type-C controller
    replaces rudimentary CC pin input
    [aux_port.kicad_sch, luna_rev0.kicad_pcb, luna_rev0.kicad_sch, target_port.kicad_sch]
2023-02-18 hardware: simplify Control port Type-C connections
    - remove CC/FPGA connections to ensure correct Rd is reliably present
    - remove SBU/FPGA connections to avoid need for ESD protection
    We provide CC and SBU pin access on the Target and Aux port. They are
    not necessary on the Control port. Simplification ensures reliability.
    [aux_port.kicad_sch, clock_pmod.kicad_sch, control_port.kicad_sch, fpga_configuration.kicad_sch, indicators_pmod.kicad_sch, luna_rev0.kicad_pcb, luna_rev0.kicad_sch, power_distribution.kicad_sch]
2023-02-18 hardware: clamp VBUS detection signals to 24 V
    [aux_port.kicad_sch, control_port.kicad_sch, luna_rev0.kicad_pcb, luna_rev0.kicad_sch, power_distribution.kicad_sch, target_port.kicad_sch]
2023-02-18 hardware: add VBUS ESD protection
    [luna_rev0.kicad_pcb, luna_rev0.kicad_sch, power_distribution.kicad_sch]
2023-02-21 hardware: protect CC and SBU pins
    add overvoltage and ESD protection for Aux port and Target port USB
    Type-C CC and SBU pins
    [aux_port.kicad_sch, luna_rev0.kicad_pcb, luna_rev0.kicad_sch, target_port.kicad_sch]
2023-02-21 hardware: rename buttons
    DFU is now PROGRAM
    RST is now RESET
    BTN is now USER
    [fpga_configuration.kicad_sch, luna_rev0.kicad_pcb, luna_rev0.kicad_sch]
2023-02-21 hardware: abbreviate microcontroller as MCU
    [fpga_configuration.kicad_sch, luna_rev0.kicad_pcb, luna_rev0.kicad_sch]
2023-02-21 hardware: capitalize port names
    [fpga_configuration.kicad_sch, luna_rev0.kicad_pcb, luna_rev0.kicad_sch]
2023-02-21 hardware: use "Exclude from bill of materials"
    Virtual components such as mounting holes and test points that do not
    require part placement now use this property instead of the DNP field.
    [aux_port.kicad_sch, clock_pmod.kicad_sch, control_port.kicad_sch, fpga_configuration.kicad_sch, luna_rev0.kicad_pcb, luna_rev0.kicad_sch, power_distribution.kicad_sch, power_supplies.kicad_sch]
2023-02-23 hardware: tune power input section
    - add base resistor to Q10A/Q10B PNP
    - adjust zener voltage
    - adjust zener series resistance
    - fix FET Q9/Q12 orientation
    [luna_rev0.kicad_pcb, luna_rev0.kicad_sch, power_distribution.kicad_sch]
2023-02-24 hardware: improve VBUS pass-through
    - add gate drive to tolerate up to 40 V without exceeding FET Vgs limitation
    - add TARGET A discharge capability
    [luna_rev0.kicad_pcb, luna_rev0.kicad_sch, power_distribution.kicad_sch, target_port.kicad_sch]
2023-02-24 hardware: component placement
    [aux_port.kicad_sch, control_port.kicad_sch, luna_rev0.kicad_pcb, luna_rev0.kicad_sch, power_distribution.kicad_sch, target_port.kicad_sch]
2023-02-24 hardware: remove FPGA JTAG connector J5
    [fpga_configuration.kicad_sch, luna_rev0.kicad_pcb, luna_rev0.kicad_sch]
2023-02-24 hardware: use .step instead of .wrl 3D models
    [luna_rev0.kicad_pcb]
2023-03-09 hardware: update layout to match schematic
    - invert USB switch D+/D- for routing convenience
    - connect *_VBUS_CLAMPED to *_VBUS_IN not *_VBUS
    - reassign FPGA pins and banks for routing convenience
    - connect PHY VBAT to +3V3, not +5V
    - add PHY VDD33 test points
    - add LED test points
    - add PROGRAM button test point
    - add PHY VDD33 test point
    - add mezzanine connector
    - improve decoupling
    [aux_port.kicad_sch, clock_pmod.kicad_sch, control_port.kicad_sch, fpga_configuration.kicad_sch, indicators_pmod.kicad_sch, luna_rev0.kicad_pcb, luna_rev0.kicad_sch, power_distribution.kicad_sch]
2023-03-11 hardware: passive component selection
    [aux_port.kicad_sch, clock_pmod.kicad_sch, control_port.kicad_sch, fpga_configuration.kicad_sch, indicators_pmod.kicad_sch, luna_rev0.kicad_pcb, luna_rev0.kicad_sch, power_distribution.kicad_sch]
2023-03-12 Back off AUX_VBUS_IN polygon from sensitive areas.
    [luna_rev0.kicad_pcb]
2023-03-12 Squashed commit of the following:
    commit 0e9b3443a5f0791f42246d75eaffd49ffb73ff13
    Author: Martin Ling <martin-git@earth.li>
    Date: Sat Mar 11 20:57:37 2023 +0000
    Second pass at silkscreen.
    commit bc39b31071113e5b4664c24391c16d3cbc8b2848
    Author: Martin Ling <martin-git@earth.li>
    Date: Fri Mar 10 03:58:11 2023 +0000
    Add additional silkscreen markings to front side.
    [luna_rev0.kicad_pcb]
2023-03-12 hardware: improve silkscreen
    - use more of the space around the FPGA
    - use different line widths to distinguish connections from boundaries
    - use curved lines for more connections
    - move vias away from silkscreen
    [luna_rev0.kicad_pcb]
2023-03-12 hardware: add shield net
    - connect directly to mounting holes
    - connect to USB shields through 0 ohm resistors
    - connect to GND through 0 ohm resistor
    [aux_port.kicad_sch, clock_pmod.kicad_sch, control_port.kicad_sch, fpga_configuration.kicad_sch, indicators_pmod.kicad_sch, luna_rev0.kicad_pcb, luna_rev0.kicad_sch, power_distribution.kicad_sch]
2023-03-13 hardware: adjust silkscreen
    [luna_rev0.kicad_pcb]
2023-03-13 hardware: improve Type-C GND connections
    [luna_rev0.kicad_pcb]
2023-03-13 hardware: exclude DNP components from .pos files
    [luna_rev0.kicad_pcb]
2023-03-15 hardware: use short name in value field
    [aux_port.kicad_sch, control_port.kicad_sch, fpga_configuration.kicad_sch, luna_rev0.kicad_pcb, luna_rev0.kicad_sch, power_distribution.kicad_sch, power_supplies.kicad_sch, ram_section.kicad_sch]
2023-03-15 hardware: update PCB stackup specification
    [aux_port.kicad_sch, clock_pmod.kicad_sch, control_port.kicad_sch, fpga_configuration.kicad_sch, indicators_pmod.kicad_sch, luna_rev0.kicad_pcb, luna_rev0.kicad_sch, power_distribution.kicad_sch]
2023-04-07 hardware: make AUX SBU pin labels consistent
    [aux_port.kicad_sch, luna_rev0.kicad_pcb, luna_rev0.kicad_sch]
2023-04-08 hardware: correct ECP5-BGA256 pin T7 name
    [aux_port.kicad_sch, clock_pmod.kicad_sch, control_port.kicad_sch, fpga_configuration.kicad_sch, indicators_pmod.kicad_sch, luna_rev0.kicad_pcb, power_supplies.kicad_sch, ram_section.kicad_sch]
2023-04-16 hardware: update version to 0.6
    [aux_port.kicad_sch, clock_pmod.kicad_sch, control_port.kicad_sch, fpga_configuration.kicad_sch, indicators_pmod.kicad_sch, luna_rev0.kicad_pcb, luna_rev0.kicad_sch, power_distribution.kicad_sch]
2023-04-16 hardware: update component selections
    - fix overheating of TVS diodes D23-D26 starting at 27 V
    - change absolute maximum VBUS from 40 V to 30 V
    [aux_port.kicad_sch, clock_pmod.kicad_sch, control_port.kicad_sch, fpga_configuration.kicad_sch, indicators_pmod.kicad_sch, luna_rev0.kicad_pcb, luna_rev0.kicad_sch, power_distribution.kicad_sch]
2023-04-16 hardware: add RC filters to buttons
    [control_port.kicad_sch, fpga_configuration.kicad_sch, luna_rev0.kicad_pcb, luna_rev0.kicad_sch]
2023-04-17 hardware: update VBUS passthrough FETs
    - reduce on resistance
    - improve power dissipation
    [luna_rev0.kicad_sch, power_distribution.kicad_sch]
2023-04-17 hardware: update +5V input diodes
    improve power dissipation
    [luna_rev0.kicad_sch, power_distribution.kicad_sch]
2023-04-17 hardware: update current sense resistor footprint
    - use standard 0603 footprint for reliable assembly
    [luna_rev0.kicad_sch, power_distribution.kicad_sch]
2023-04-17 hardware: assign PCLK pin to mezzanine connector
    swap with PMOD A pins
    [indicators_pmod.kicad_sch]
2023-04-17 hardware: add series resistor to 60 MHz clock
    [clock_pmod.kicad_sch, luna_rev0.kicad_sch]
2023-04-18 hardware: update pull-up and pull-down resistors
    - do not populate unnecessary resistors
    - remove some unnecessary 0 ohm resistors
    - add recommended FPGA resistors
    - add recommended MCU resistors
    - update hardware version detection pin strap
    - change CONTROL port USB switch default to MCU
    [aux_port.kicad_sch, control_port.kicad_sch, fpga_configuration.kicad_sch, luna_rev0.kicad_sch, power_distribution.kicad_sch, target_port.kicad_sch]
2023-04-18 hardware: improve heat dissipation
    [luna_rev0.kicad_sch]
2023-04-18 hardware: update LED footprint
    [fpga_configuration.kicad_sch, indicators_pmod.kicad_sch, luna_rev0.kicad_sch]
2023-05-01 hardware: clean up schematic for readability
    [aux_port.kicad_sch, control_port.kicad_sch, luna_rev0.kicad_sch]
2023-05-01 hardware: update button RC filters for reliability
    [fpga_configuration.kicad_sch, luna_rev0.kicad_sch]
2023-05-01 hardware: update FET component selection
    [luna_rev0.kicad_sch, power_distribution.kicad_sch]
2023-05-01 hardware: fix via/silkscreen interference
2023-05-01 hardware: reduce paste area for 1006 diodes
2023-05-01 hardware: update version detection pin strap
    [fpga_configuration.kicad_sch, luna_rev0.kicad_sch]
2023-05-01 hardware: rename to Cynthion
    [aux_port.kicad_sch, clock_pmod.kicad_sch, control_port.kicad_sch, cynthion.kicad_sch, fpga_configuration.kicad_sch, indicators_pmod.kicad_sch, luna_rev0.kicad_sch, power_distribution.kicad_sch]
2023-05-04 hardware: nudge vias out of title silkscreen area
2023-05-17 hardware: adjust table in schematic
    [cynthion.kicad_sch, fpga_configuration.kicad_sch]
2023-05-18 hardware: change U1 from WLCSP to VQFN package
    [clock_pmod.kicad_sch, cynthion.kicad_sch, power_distribution.kicad_sch]
2023-05-18 hardware: increase minimum trace/space to 5 mil
2023-05-18 hardware: change FPGA_INT pin assignment
    This avoids an issue with FPGA_INT toggling during FPGA configuration.
    [fpga_configuration.kicad_sch]
2023-06-06 hardware: update version to 1.1.1
    - adjust PROGRAM and RESET button placement to match USER button
