mossmann/luna/(notices)

Notices in the files:
hardware/cynthion/cynthion.kicad_sch:
Copyright 2019-2023 Great Scott Gadgets
Licensed under the CERN-OHL-P v2
